rcyaon/bidir-level-shifter/layout/renders/copper/01_iso_overview.png

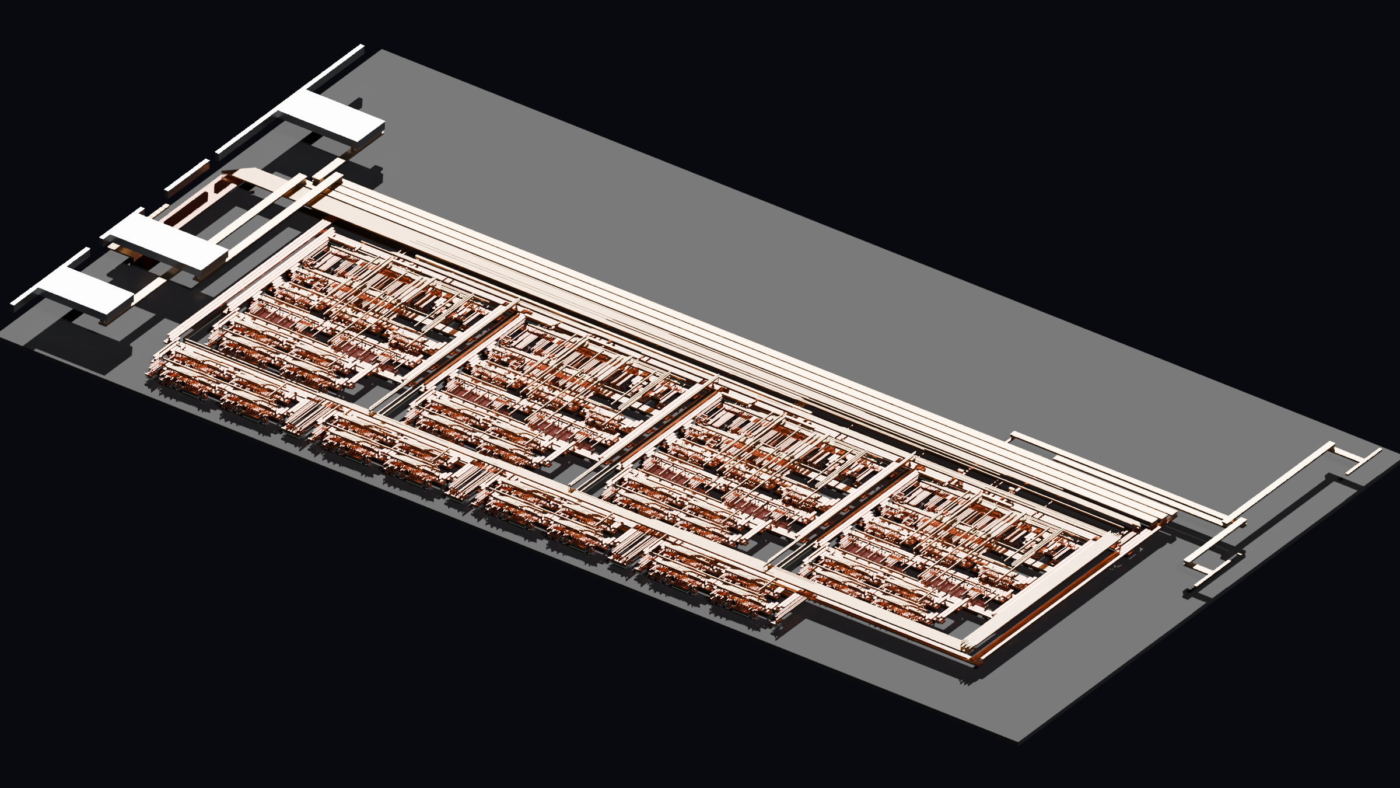
layout/renders/copper/01_iso_overview.png
