rcyaon/bidir-level-shifter/layout/renders/copper/02_top_down.png

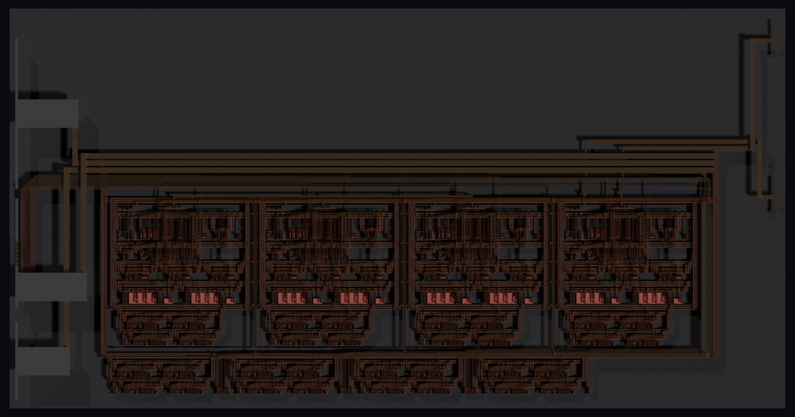
layout/renders/copper/02_top_down.png
