rcyaon/bidir-level-shifter/layout/renders/copper/03_low_angle.png

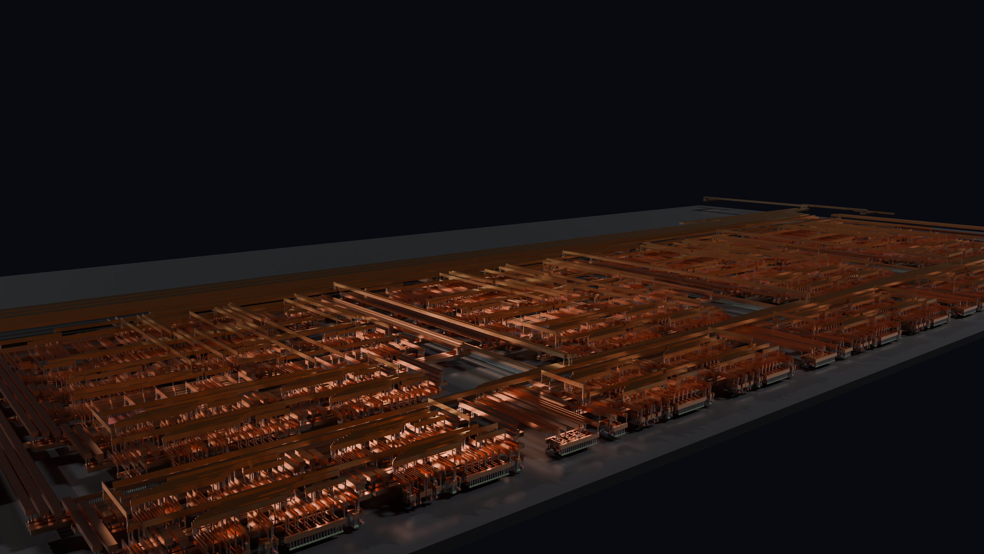
layout/renders/copper/03_low_angle.png
