rcyaon/bidir-level-shifter/layout/renders/copper/04_closeup.png

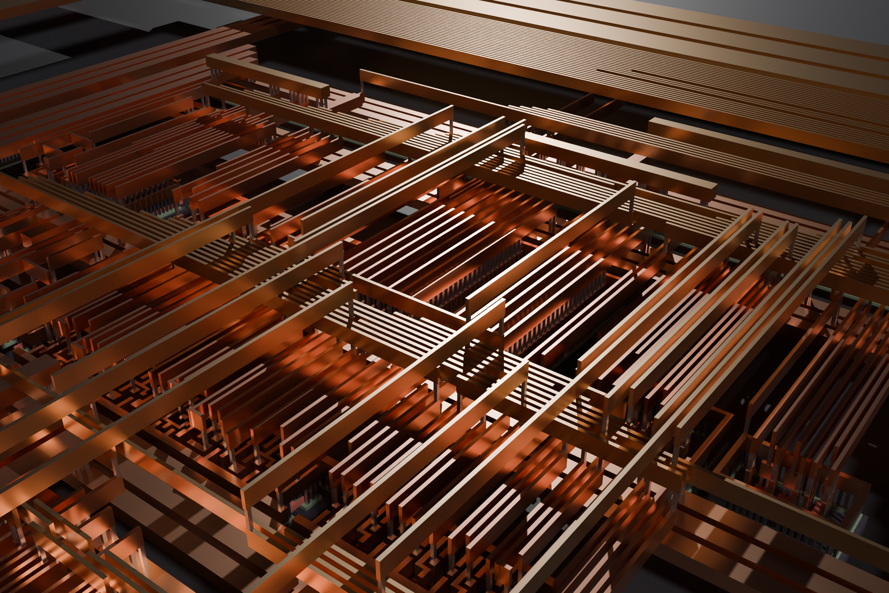
layout/renders/copper/04_closeup.png
