rcyaon/bidir-level-shifter/layout/renders/original/02_top_down.png

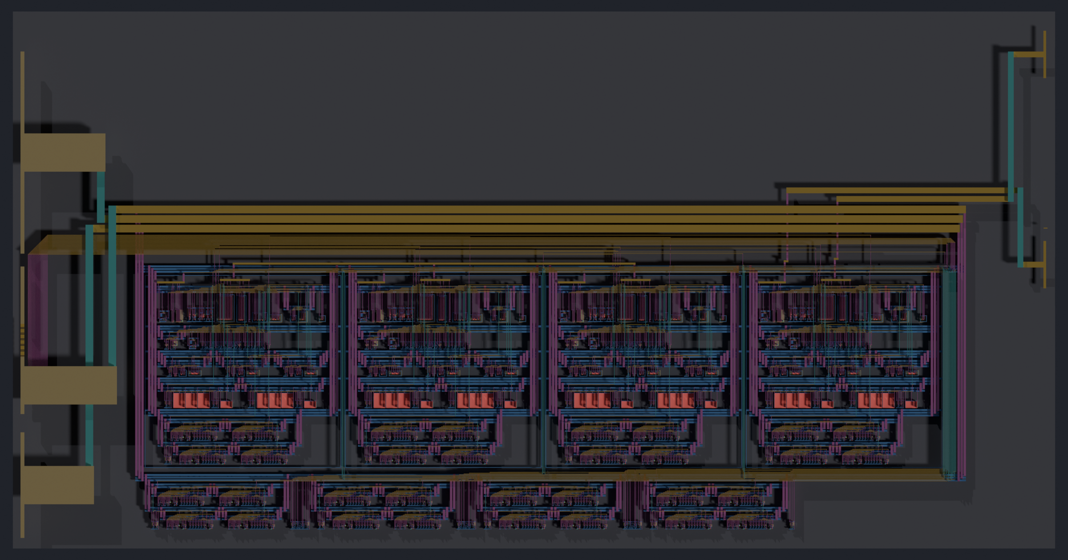
layout/renders/original/02_top_down.png
