rcyaon/bidir-level-shifter/layout/renders/original/04_closeup.png

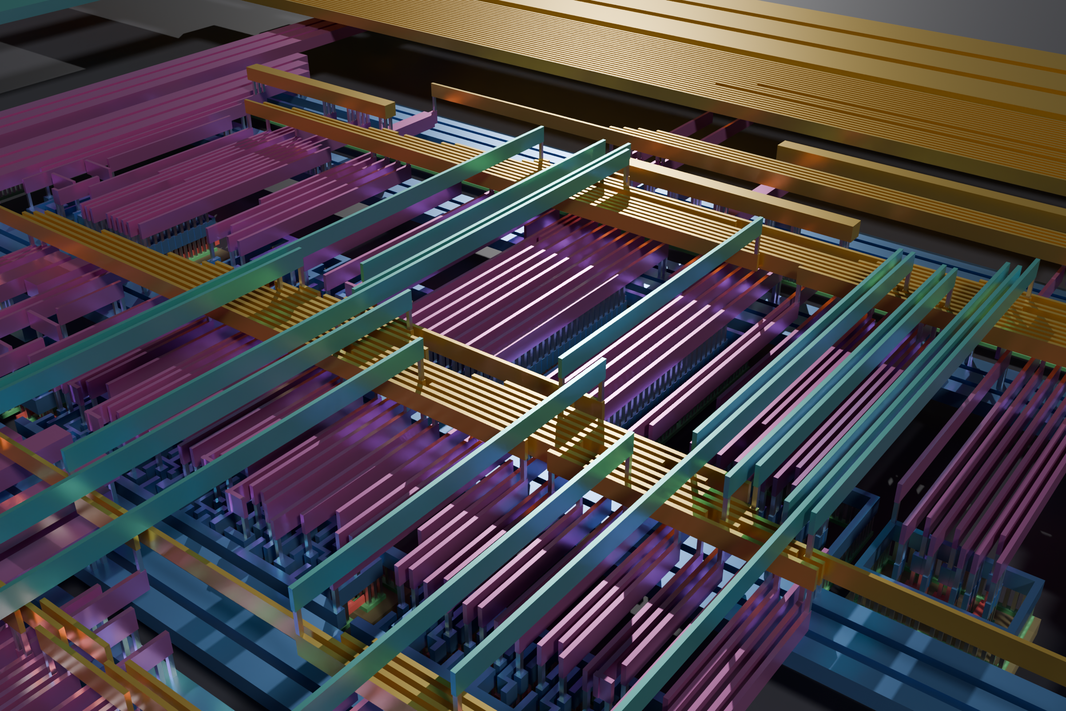
layout/renders/original/04_closeup.png
