rcyaon/bidir-level-shifter/layout/renders/original/05_closeup_detail.png

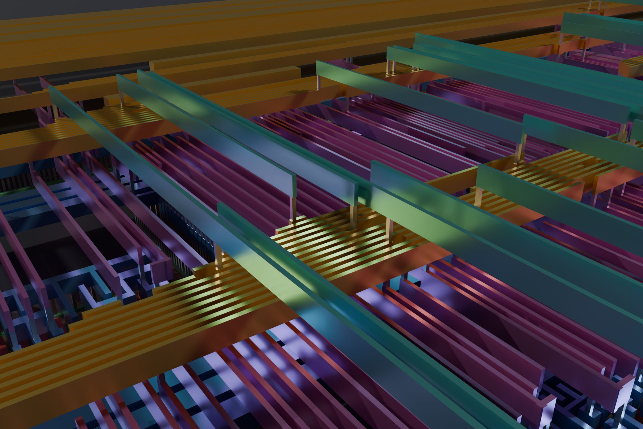
layout/renders/original/05_closeup_detail.png
