rcyaon/bidir-level-shifter/layout/renders/original/06_exploded.png

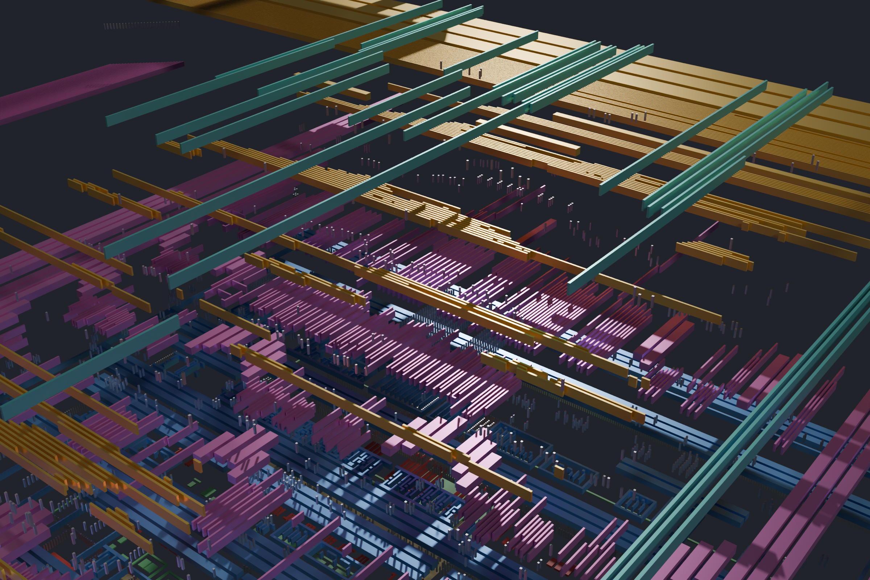
layout/renders/original/06_exploded.png
