rcyaon/bidir-level-shifter/layout/renders/slate/01_iso_overview.png

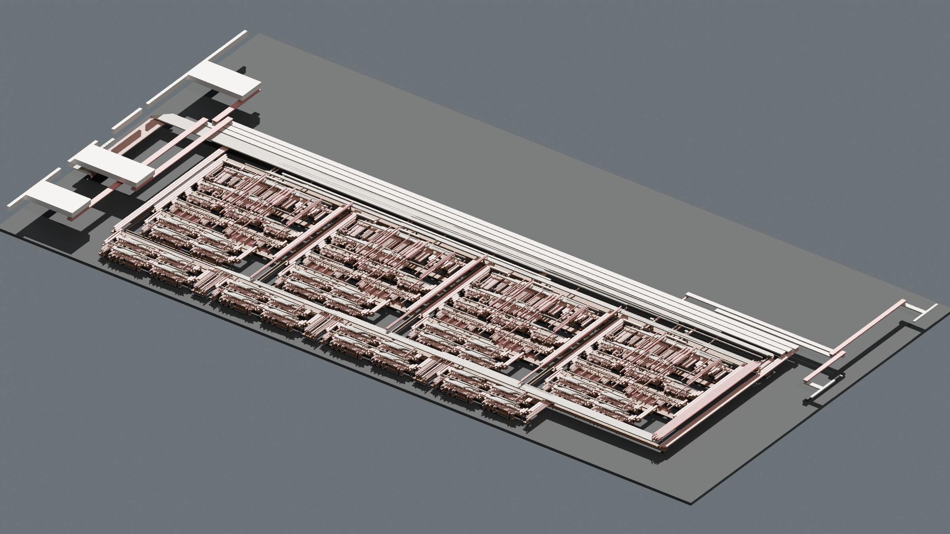
layout/renders/slate/01_iso_overview.png
