rcyaon/bidir-level-shifter/layout/renders/slate/02_top_down.png

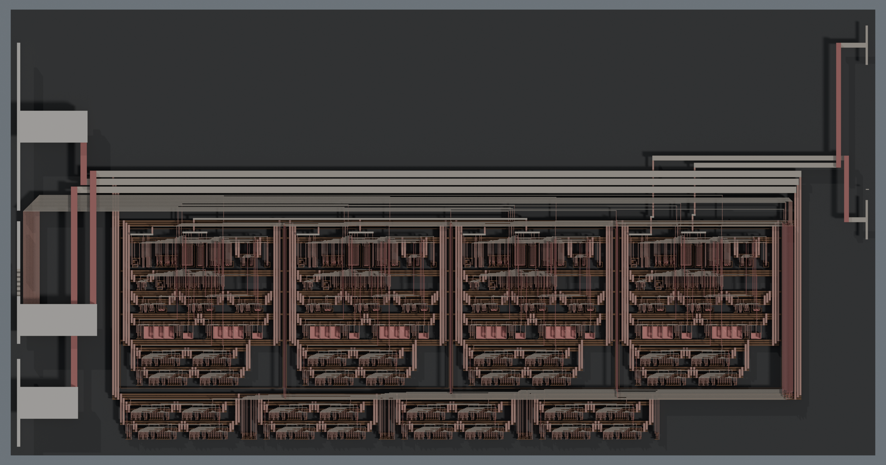
layout/renders/slate/02_top_down.png
