rcyaon/bidir-level-shifter/layout/renders/slate/03_low_angle.png

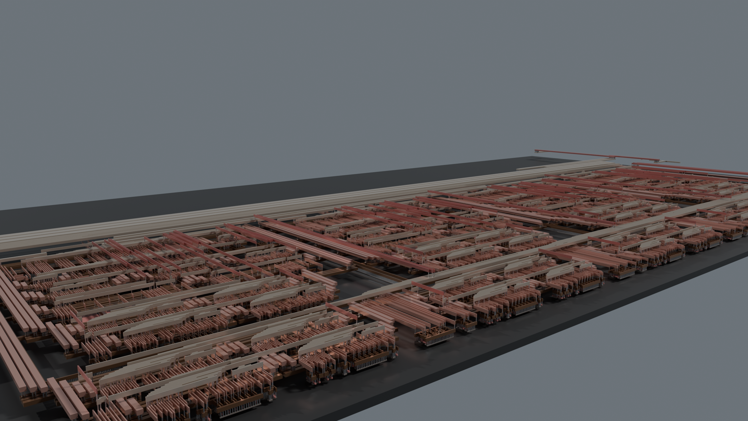
layout/renders/slate/03_low_angle.png
