rcyaon/bidir-level-shifter/layout/renders/slate/04_closeup.png

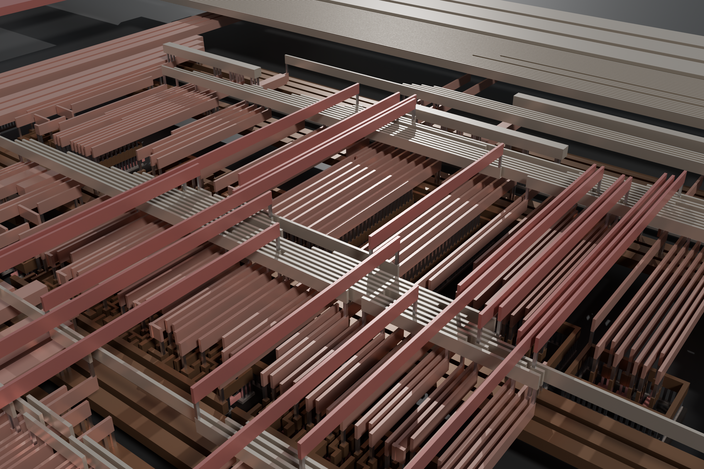
layout/renders/slate/04_closeup.png
