rcyaon/bidir-level-shifter/layout/renders/slate/05_closeup_detail.png

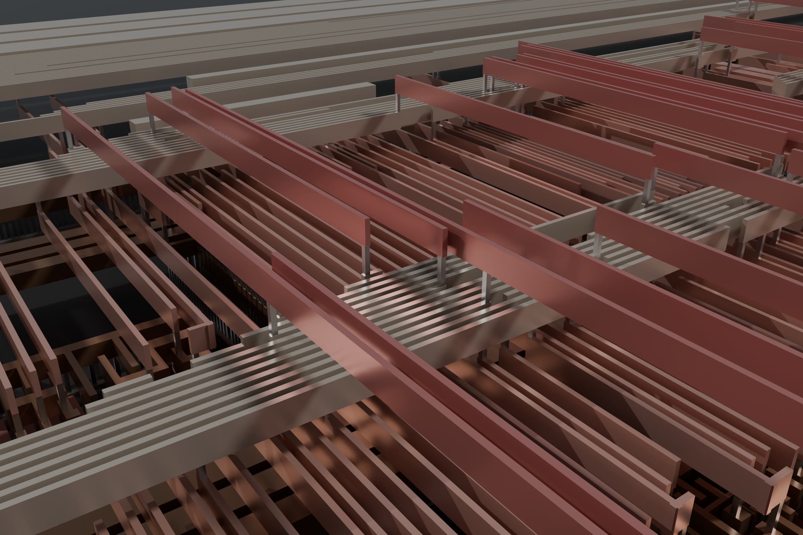
layout/renders/slate/05_closeup_detail.png
