rcyaon/bidir-level-shifter/layout/renders/slate/06_exploded.png

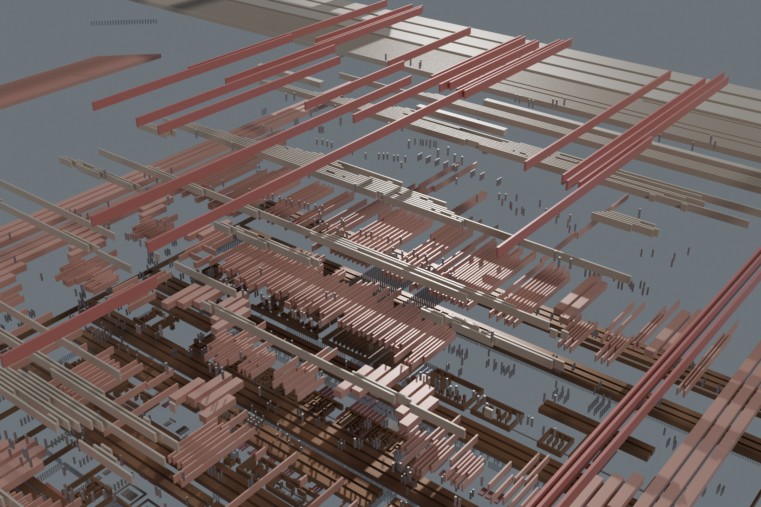
layout/renders/slate/06_exploded.png
