rcyaon/bidir-level-shifter/layout/renders/slate/07_layout_2d.png

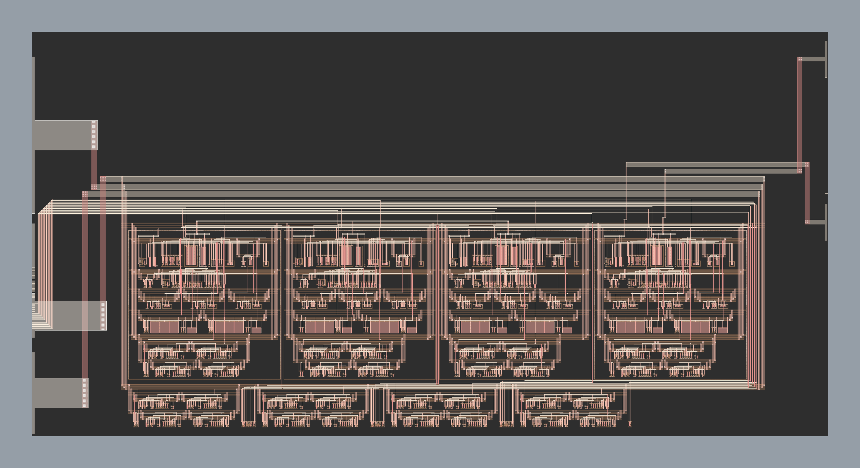
layout/renders/slate/07_layout_2d.png
