rcyaon/bidir-level-shifter/layout/renders/slate/08_bidir_channel_2d.png

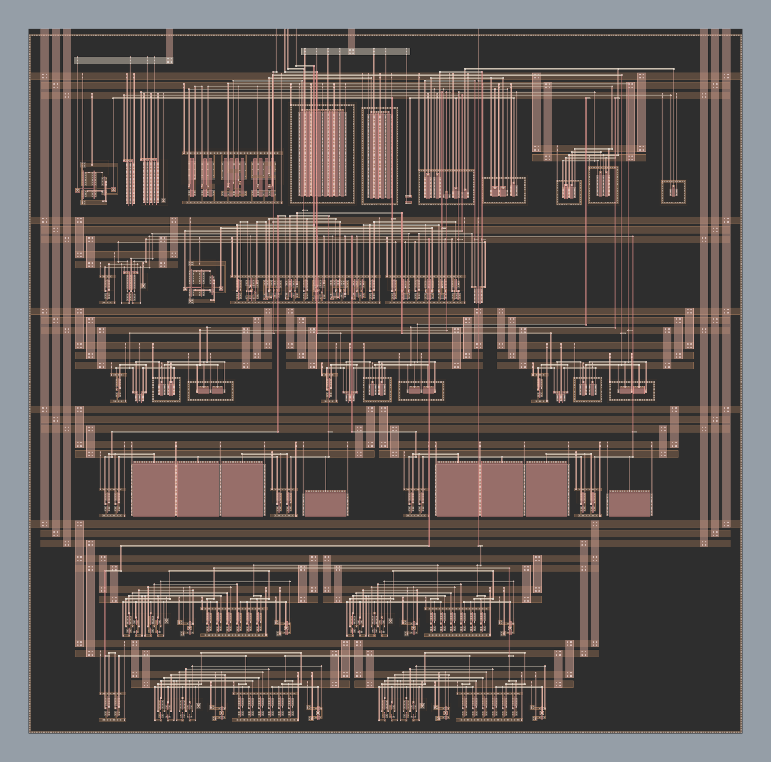
layout/renders/slate/08_bidir_channel_2d.png
