rcyaon/bidir-level-shifter/(commit log)

2026-09-03 push schematic
    [AND2LV.sch, AND3LV.sch, CH.sch, CTRLLS.sch, DFFLV.sch, DIV16.sch, DLY2NS.sch, INVHV.sch]
2026-09-03 Update README to remove schematic details
    Removed introductory details about the channel schematic and documentation links.
2026-09-25 clean up
    [AND2LV.sch, AND3LV.sch, CH.sch, CTRLLS.sch, DFFLV.sch, DIV16.sch, DLY2NS.sch, INVHV.sch]
2026-10-01 update updates
    [bidir_channel.sch]
